ymkn/MonakaPad/README.md

# MonakaPad

Tadpole Pinマウントやスクリューレス機構などを試すためのマクロパッド

## ビルドガイド

[doc/buildguide.md](doc/buildguide.md)

## LICENSE

This project is licensed under the MIT License, see the [LICENSE file](LICENSE) for details.
