ymkn/MonakaPad/FreeCAD/MonakaPad_PCB.step

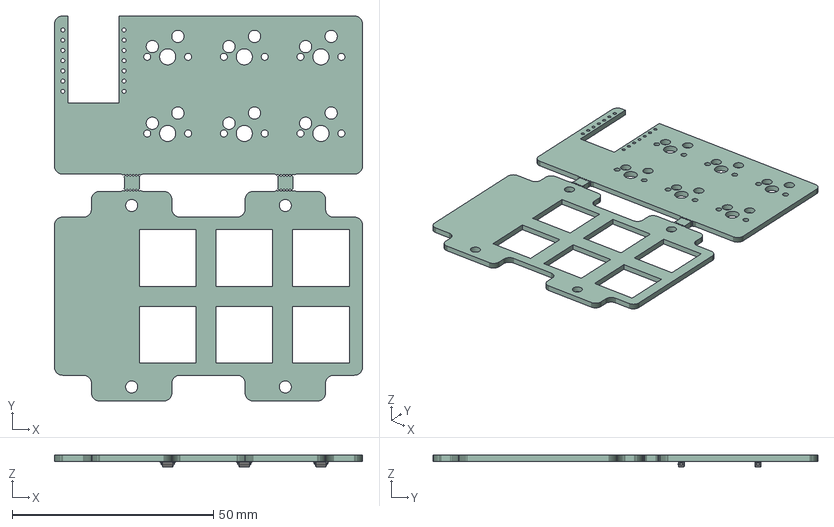
[picture p1: CAD file, 2024-05-02]
FreeCAD/MonakaPad_PCB.step
76.6 x 95.7 x 2.90 mm
D_SOD_123 x 6
MonakaPad_PCB PCB
