ymkn/MonakaPad/FreeCAD/MonakaPad_Case.step

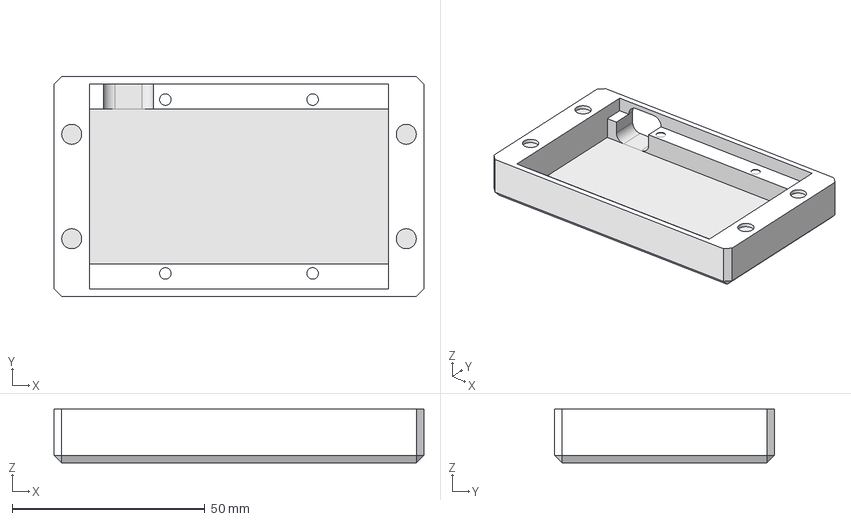
[picture p2: CAD file, 2024-05-02]
FreeCAD/MonakaPad_Case.step
96.0 x 57.1 x 14.0 mm
