ymkn/MonakaPad/FreeCAD/MonakaPad_TopCase.step

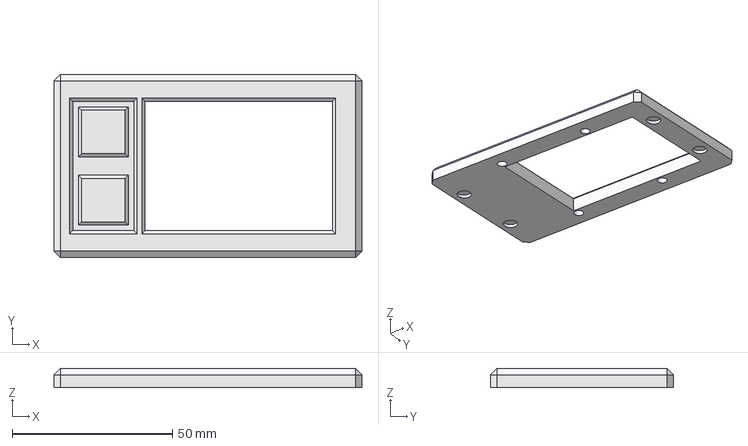
[picture p3: CAD file, 2024-05-02]
FreeCAD/MonakaPad_TopCase.step
96.0 x 57.1 x 6.00 mm
