ymkn/MonakaPad/(list of files, cad)

Other CAD files:
FreeCAD/MonakaPad_Case.FCStd
FreeCAD/MonakaPad_TopCase.FCStd
