ymkn/MonakaPad/KiCAD/MonakaPad_PCB/MonakaPad_PCB.kicad_pcb

## KiCad design KiCAD/MonakaPad_PCB/MonakaPad_PCB.kicad_pcb (2024-05-02)

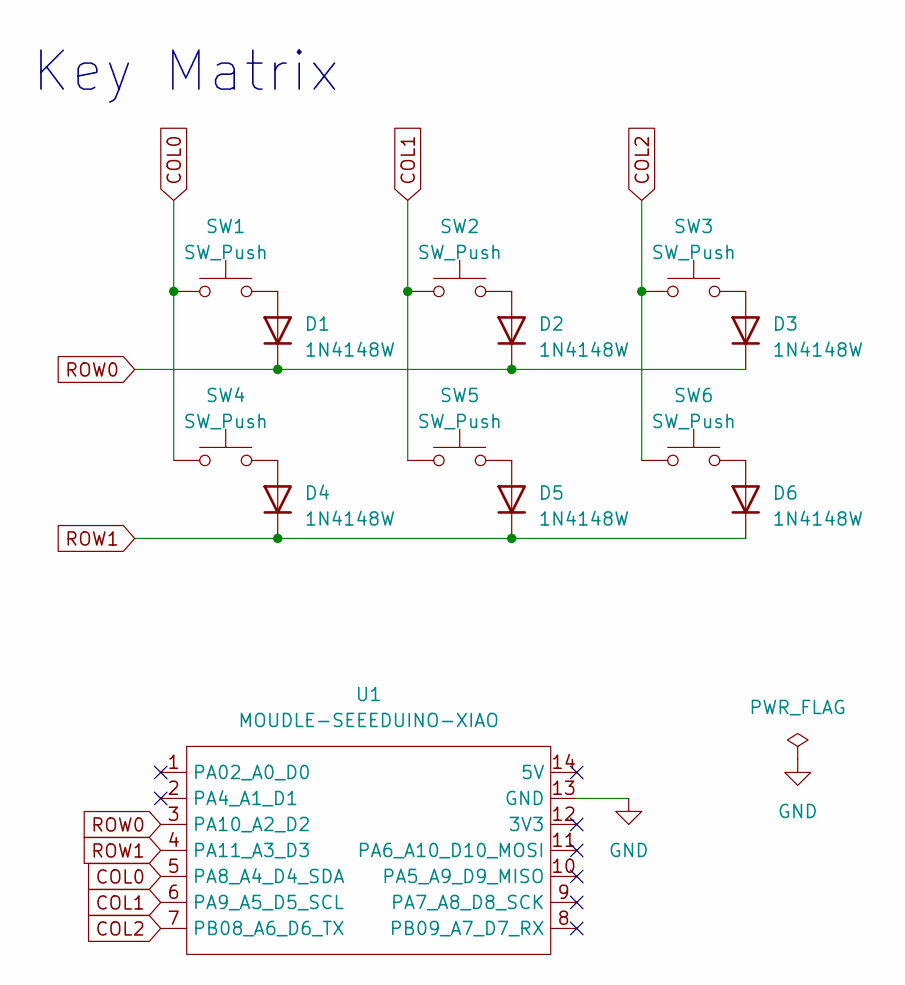
[picture p4: schematic MonakaPad_PCB.kicad_sch, MonakaPad]

Parts:
D1, D2, D3, D4, D5, D6: 1N4148W; D_SOD-123; LCSC Parts # C81598
SW1, SW2, SW3, SW4, SW5, SW6: SW_Push; SW_Hotswap_Kailh_MX_1.00u
U1: MOUDLE-SEEEDUINO-XIAO; MOUDLE14P-2.54-21X17.8MM

Connections:
COL0: SW1.1, SW4.1, U1.5 (PA8_A4_D4_SDA); also elsewhere on the board
COL1: SW2.1, SW5.1, U1.6 (PA9_A5_D5_SCL); also elsewhere on the board
COL2: SW3.1, SW6.1, U1.7 (PB08_A6_D6_TX); also elsewhere on the board
unnamed: D1.2 (A), SW1.2
unnamed: D2.2 (A), SW2.2
unnamed: D3.2 (A), SW3.2
unnamed: D4.2 (A), SW4.2
unnamed: D5.2 (A), SW5.2
unnamed: D6.2 (A), SW6.2
ROW0: D1.1 (K), D2.1 (K), D3.1 (K), U1.3 (PA10_A2_D2); also elsewhere on the board
ROW1: D4.1 (K), D5.1 (K), D6.1 (K), U1.4 (PA11_A3_D3); also elsewhere on the board

Notes on the sheet:
Key Matrix

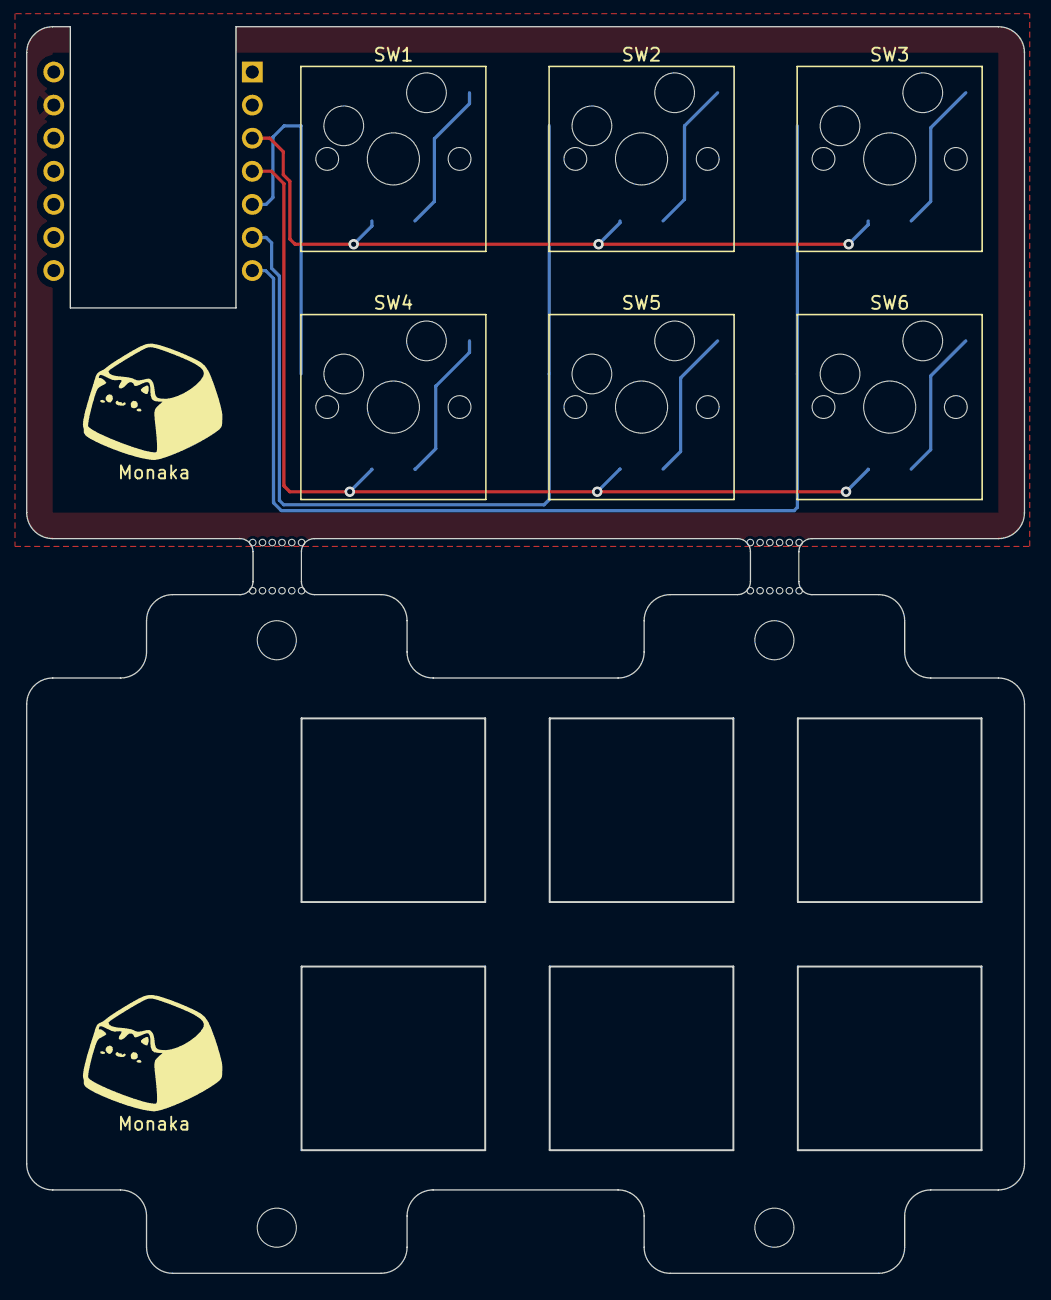
[picture p5: board MonakaPad_PCB.kicad_pcb from above]

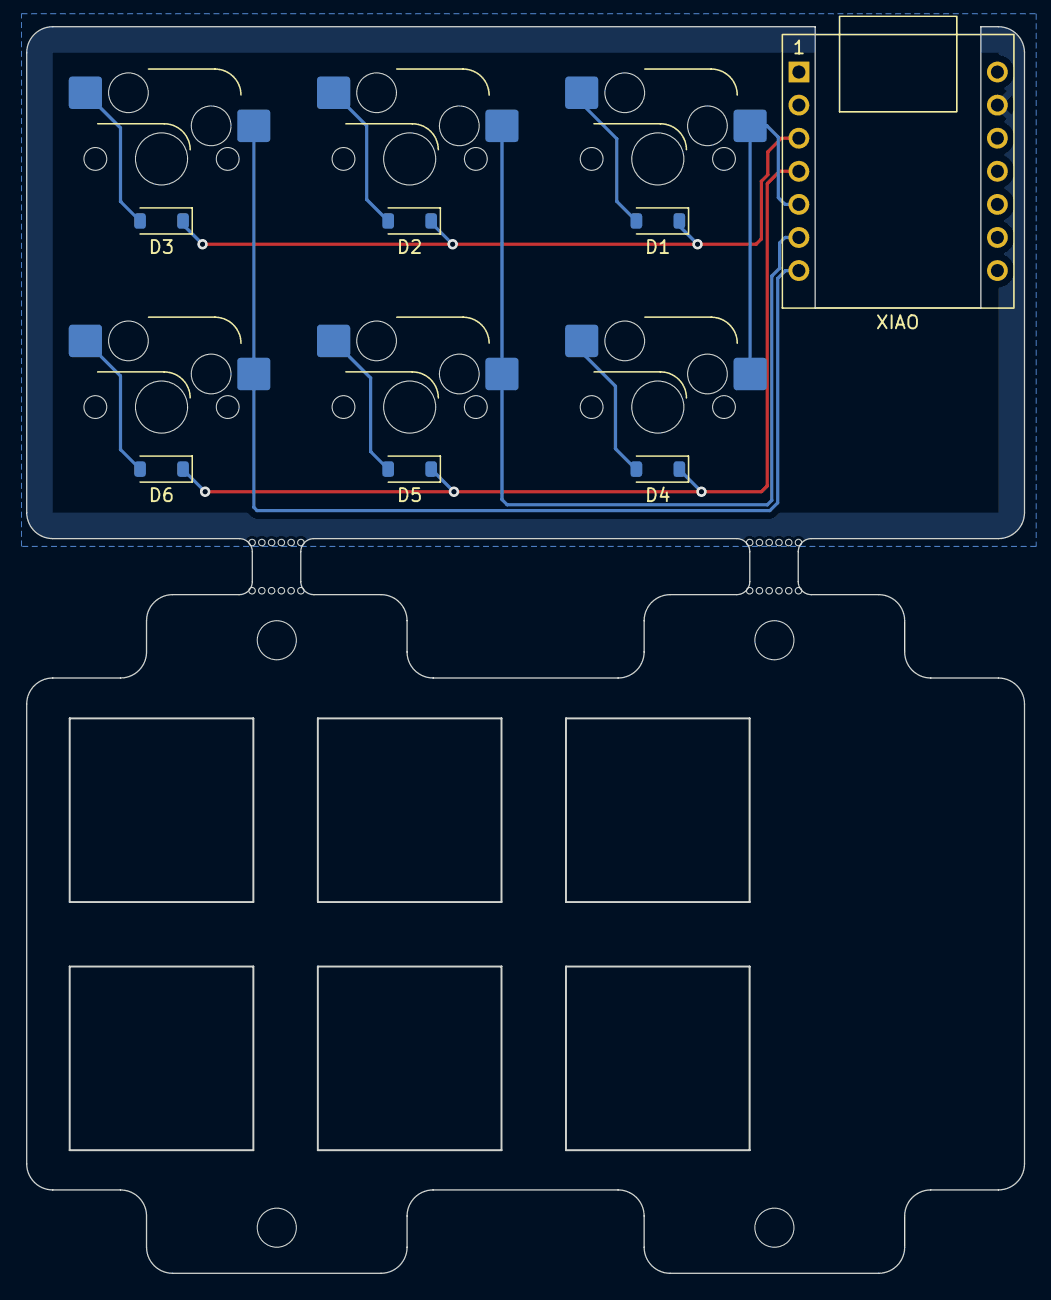
[picture p6: board MonakaPad_PCB.kicad_pcb from below]

Board: 2 copper layers, 76.6 x 95.7 mm, 23 parts (7 on the bottom side), 11 nets.

Other parts of the board:
Ref**: Val**; Mouse_Bite_Hole
Ref**#2, Ref**#3, Ref**#4: Val**; Mouse_Bite_Hole
SW1-Hole, SW2-Hole, SW3-Hole, SW4-Hole, SW5-Hole, SW6-Hole: SW_Push; SW_Hole_1u_JLC
XIAO: MOUDLE-SEEEDUINO-XIAO; MOUDLE14P-2.54-21X17.8MM

Their connections:
COL0: XIAO.5 (PA8_A4_D4_SDA); also elsewhere on the board
COL1: XIAO.6 (PA9_A5_D5_SCL); also elsewhere on the board
COL2: XIAO.7 (PB08_A6_D6_TX); also elsewhere on the board
ROW0: XIAO.3 (PA10_A2_D2); also elsewhere on the board
ROW1: XIAO.4 (PA11_A3_D3); also elsewhere on the board
