ymkn/MonakaPad/(commit log)

2024-05-02 リンクの修正
2024-05-02 項番のズレを修正
2024-05-02 誤字の修正
